fhidalgoh31/WChair/Board.png

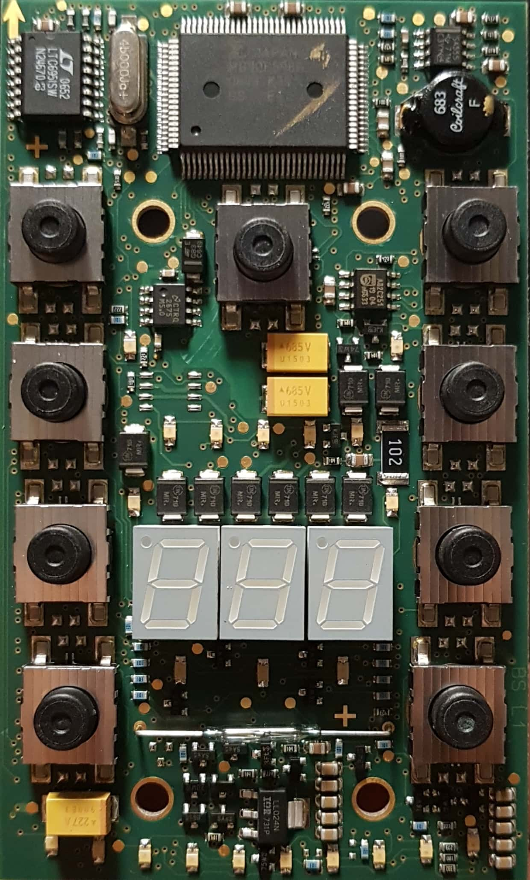
Board.png
