fhidalgoh31/WChair/chair_test/I2C-Master/README.md

The I2C Master library is an alternative library to Arduino's Wire library.
