fhidalgoh31/WChair/Motor controller selection.odt

# Motor controller – for driving the auxiliary motors forward - backwards

# Sabertooth 2X12 Dual Motor Driver – 24V 12 A

https://www.robotgear.com.au/Product.aspx/Details/461-Sabertooth-2X12-Dual-Motor-Driver

#### AUD $147.95

Qty needed: 2 → 4 motors

Connections: Screw terminals (not micro-fit)

Communication: 1 wire from Roboteq

Control: Needs configuration and some programming

Mounting: Mounting holes, no housing

Also needed (Qty=1):

https://www.altronics.com.au/p/z6369-rs232-serial-to-ttl-converter/

https://www.altronics.com.au/p/p1017-prototyping-jumper-wires-mixed-for-breadboard-arduino/

# Cytron Dual Channel 10A DC Motor Driver – 25 V 10A MAX

https://www.iot-store.com.au/products/cytron-dual-channel-10a-dc-motor-driver

AUD $25.00

Qty needed: 2 → 4 motors

Connections: Screw terminals (not micro-fit)

Communication: 8 Wires from Roboteq

Control: Straightforward use with Digital outputs from Roboteq

Mounting: Mounting holes, no housing

Also needed (Qty=1):

https://www.banggood.com/8-Channel-24V-To-5V-Optocoupler-Isolation-Module-PLC-Signal-Level-Voltage-Conversion-Board-p-1202825.html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

# Roboteq SDC2160 - Brushed DC Motor Controller, Dual Channel, 2 x 20A, 60V

https://www.roboteq.com/index.php/component/virtuemart/307/sdc2160-detail?Itemid=970

USD $250.00

Qty needed: 2 → 4 motors

Connections: Screw terminals (not micro-fit)

Communication: 2 Wires from Roboteq, CAN BUS

Control: CAN BUS from Roboteq, requires programming

Mounting: Mounting holes, housing

Note: Probably overkill

Voltage Regulator:

24V | V (v) | I (A) | qty | Sub
Nidec 404 682 x 4 | 24 | 3.5 | 1 | 3.5 | http://nidec-ma.de/en/productlist.html
Brake ??? | 24 | 2 | 1 | 2
Lights | 24 | | | 0
Roboteq | 24 | 0.1 | 1 | 0.1
Servo Nide 404.854 | 24 | 6 | 1 | 6
| | | | > 10 A | 240 W

# B70SR24125CC

24V, In: 36- 106V, 12.5A, 300W

https://www.digikey.com.au/product-detail/en/delta-electronics/B70SR24125CC/941-1809-ND/7681586 (https://www.digikey.com.au/product-detail/en/delta-electronics/B70SR24125CC/941-1809-ND/7681586)

Includes an Enable/Disable signal useful for saving power and lifespan

AU$209.02

Dim: 190.0mm x 75.9mm x 43.9mm

B62SR24015CC

24V, 360W, 15A

https://www.digikey.com.au/product-detail/en/delta-electronics/B62SR24015CC/1145-1283-ND/9598967

Includes an Enable/Disable signal useful for saving power and lifespan

AUD $272.00

Connection: Molex Mini Fit (Included)

Dim: 190.0mm x 76.0mm x 44.0mm

# SD-350C-24

https://www.digikey.com.au/product-detail/en/mean-well-usa-inc/SD-350C-24/1866-4431-ND/7706520

350W, 14.6 A

AU$135.60

Input: 36- 72V

Dim: 215.0mm x 115.0mm x 50.0mm

Molex: Micro Fit, Male:

AU$3.70

https://www.digikey.com.au/product-detail/en/molex-llc/0430450829/WM10700-ND/3310210

Joystick

We can go to:

http://www.controldevices.net/P&G/Joysticks.html

http://www.controldevices.net/contactus.html

Option:

https://www.digikey.com.au/product-detail/en/apem-inc/HF11S10/1040-1098-ND/4291721

https://www.digikey.com.au/product-detail/en/apem-inc/505-442/1040-1041-ND/4246202

Lists:

https://www.digikey.com.au/products/en/switches/navigation-switches-joystick/204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

https://au.rs-online.com/web/c/switches/joystick-switches-accessories/joystick-switches/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,4294840285,4294877055,4294885167,4294880316,4294885351,4294885229
