fhidalgoh31/WChair/pinout.xlsx

 |  |  | Top, capacitor, connector
 |  |  | in line to mini molex 8 pins -- male |  |  |  |  |  |  |  | joy
 |  |  |  | 8 | 6 |  |  |  | 1 | 4 | 1 | 8 | black | vcc
 |  | ext wired |  | gnd | 7 | 2 |  | 5 |  | 3 | 2 | 6 | white | left/right out 1
 |  |  |  |  |  |  |  |  |  |  | 3 | 7 | red | gnd
 |  |  |  |  |  |  |  |  |  |  | 4 | 2 | blue | forward/reverse out 1
 |  |  | Molex
Joystick | (numbers across)
1 | vcc |  | green
2 | left/right out 1
3 | gnd |  | notch
4 | forward/reverse out 1
5 | forward/reverse out 2
6 | Centre trap
7 | left/right out 2
 |  |  | Joystick 10 pin connector
 |  |  | MALE
 |  |  | vcc |  | vcc | gnd | gnd
 |  |  | gnd | CAN | CAN
 |  |  |  | notch
