fhidalgoh31/WChair/WIring/Wiring.pdf

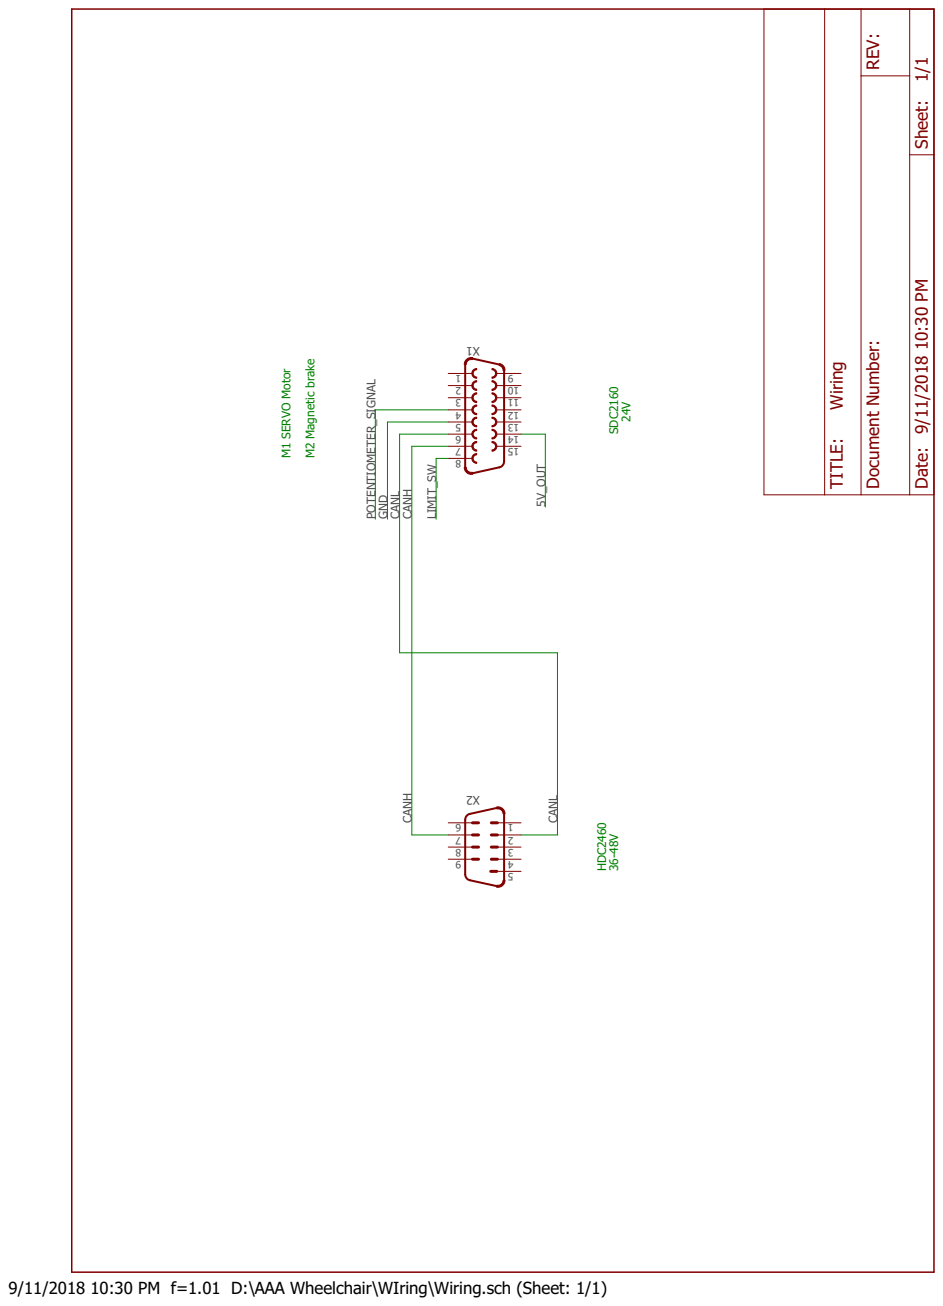
[picture p2: page 1]

M1 SERVO Motor M2 Magnetic brake

9/11/2018 10:30 PM f=1.01 D:\AAA Wheelchair\WIring\Wiring.sch (Sheet: 1/1)
