fhidalgoh31/WChair/Board/wchair.brd

## EAGLE design Board/wchair.brd (2019-07-08)

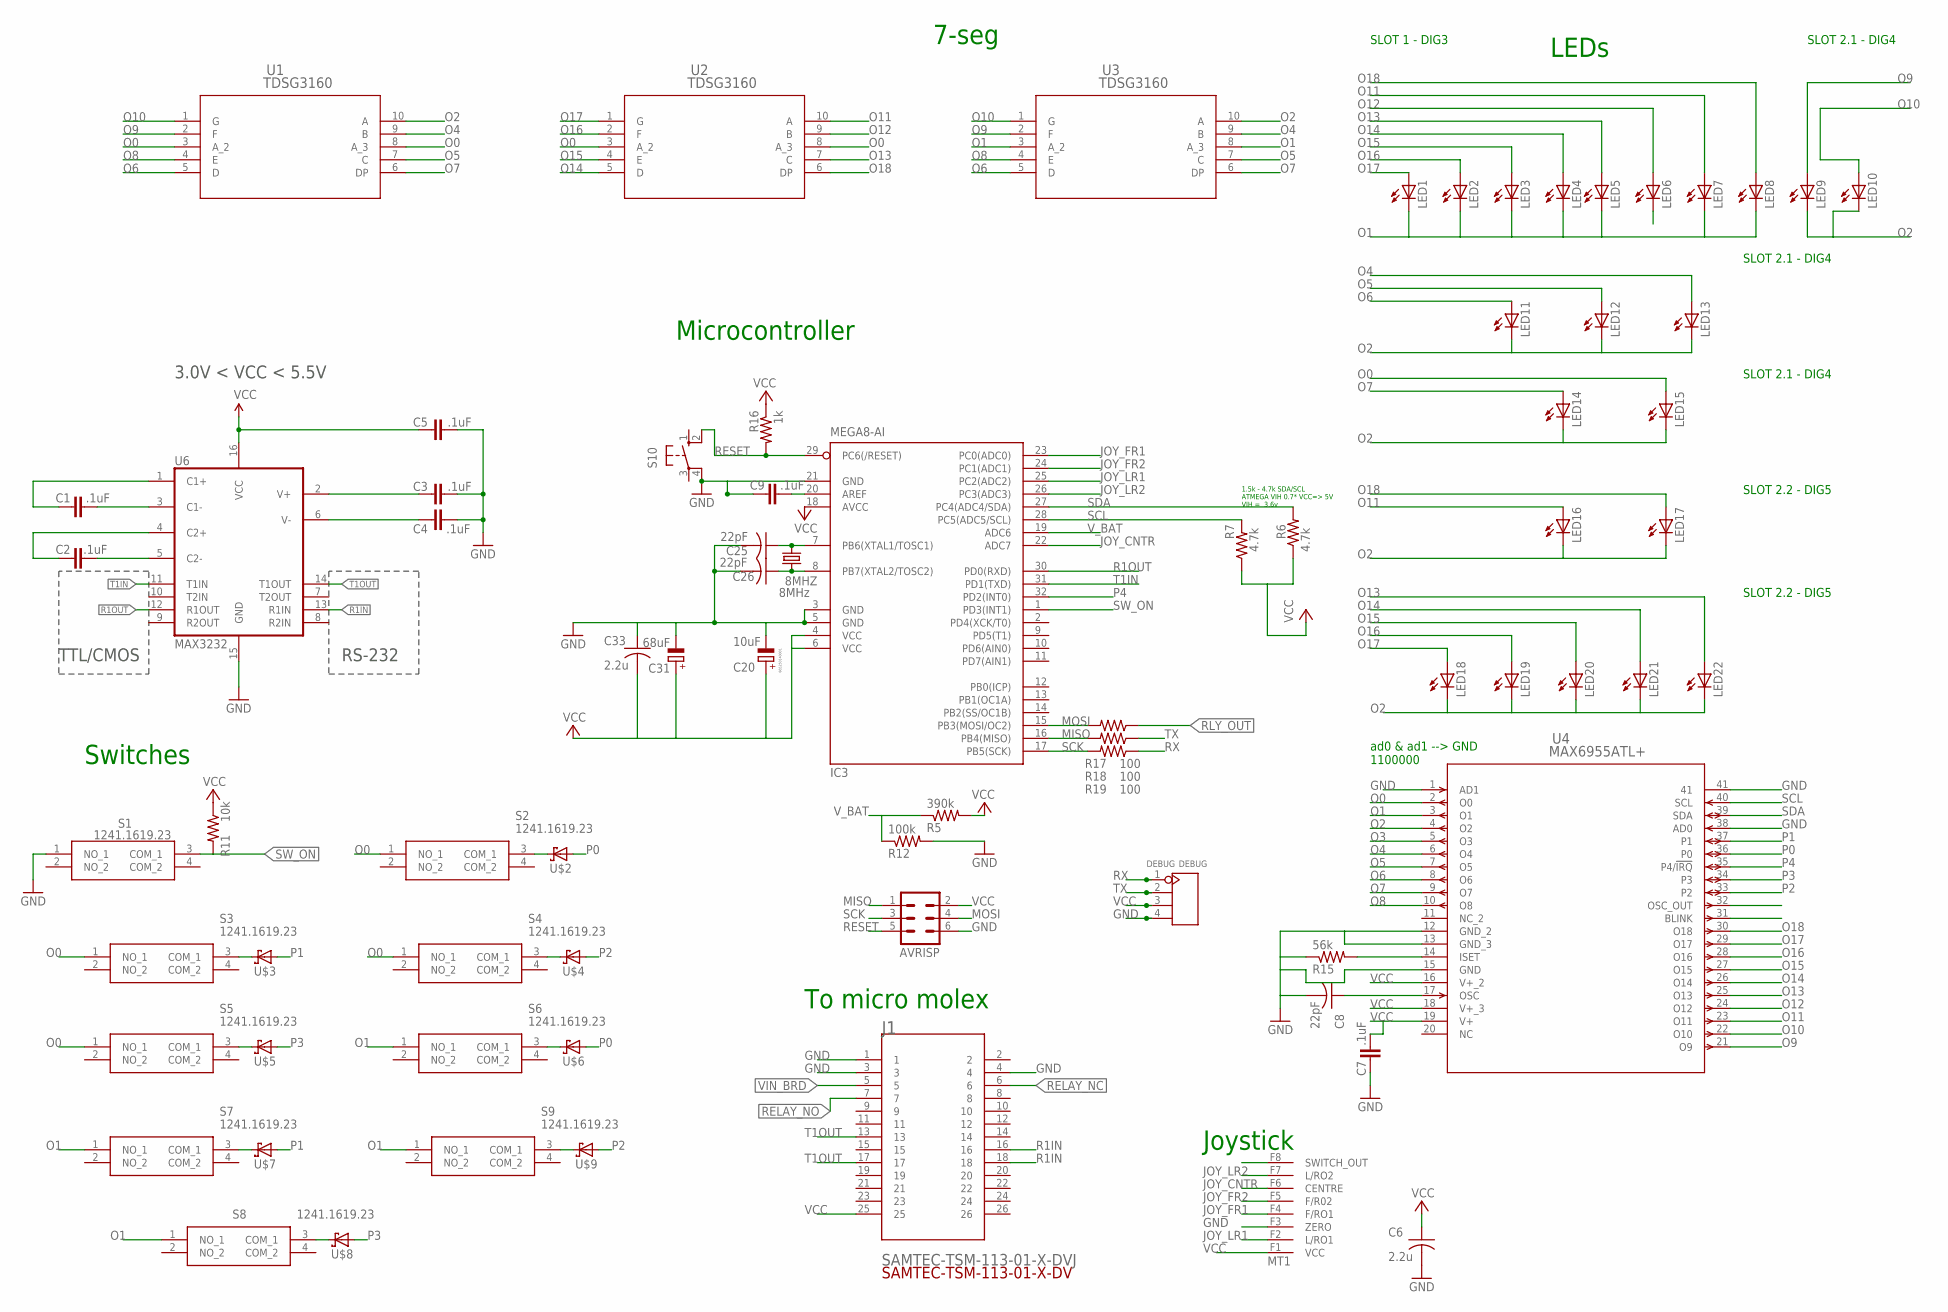
[picture p3: schematic wchair.sch, sheet 1]

Parts:
8MHZ: 8MHz; SM49; DIGIKEY 535-9089-1-ND
AVRISP: MA03-2; DIGIKEY ED10665-ND
C1, C2, C3, C4, C5, C7, C9: .1uF; 0603-CAP; DIGIKEY 399-15351-1-ND
C6, C33: 2.2u; C0603; DIGIKEY 1276-1183-1-ND
C8, C25, C26: 22pF; C0603; DIGIKEY 478-11384-1-ND
C20: 10uF; 153CLV-0405; DIGIKEY 493-2173-1-ND
C31: 68uF; 153CLV-0807; DIGIKEY PCE4412CT-ND‎
DEBUG: DEBUG; 4-PIN-HEADER; DIGIKEY 0
IC3: MEGA8-AI; TQFP32-08; DIGIKEY ATMEGA328P-AU-ND
J1: SAMTEC-TSM-113-01-X-DVJ; SAMTEC-TSM-113-01-X-DV
LED1, LED2, LED3, LED4, LED5, LED6, LED7, LED8, LED9, LED10, LED11, LED12, LED13, LED14, LED15, LED16, LED17, LED18, LED19, LED20, LED21, LED22: LEDCHIP-LED0805; CHIP-LED0805; DIGIKEY 1497-1434-1-ND
MT1: MINITEK2-8PINS
R5: 390k; R0603; DIGIKEY 311-390KGRCT-ND
R6, R7: 4.7k; R0603; DIGIKEY 311-4.7KGRCT-ND
R11: 10k; R0603; DIGIKEY RNCP0603FTD10K0CT-ND
R12: 100k; R0603; DIGIKEY RR08P100KDCT-ND
R15: 56k; R0603; DIGIKEY 749-1667-1-ND
R16: 1k; R0603; DIGIKEY RHM1.0KDCT-ND
R17, R18, R19: 100; R0603; DIGIKEY RR08P100DCT-ND
S1, S2, S3, S4, S5, S6, S7, S8, S9: 1241.1619.23; IP40-J-LEAD; DIGIKEY 486-1931-1-ND
S10: 10-XX; B3F-10XX; DIGIKEY SW400-ND
U1, U2, U3: TDSG3160; DIP10_TDS; DIGIKEY TDSG3160-M-ND
U4: MAX6955ATL+; 21-0141I_T4066-5
U6: MAX3232; SO16; DIGIKEY 296-14619-1-ND
U$2, U$3, U$4, U$5, U$6, U$7, U$8, U$9: SCHOTTKY; SOD-323

Connections:
C1+: C1.1, U6.1 (C1+)
C1-: C1.2, U6.3 (C1-)
C2+: C2.1, U6.4 (C2+)
C2-: C2.2, U6.5 (C2-)
GND: AVRISP.6, C3.2, C4.2, C5.2, C6.2, C7.1, C8.2, C9.1, C20.-, C25.2, C26.2, C31.-, C33.1, DEBUG.4, IC3.3 (GND), IC3.5 (GND), IC3.21 (GND), J1.1, J1.3, J1.4, MT1.F3 (ZERO), R12.2, R15.1, S1.1 (NO_1), S10.4 (P1), U4.1 (AD1), U4.12 (GND_2), U4.13 (GND_3), U4.15 (GND), U4.38 (AD0), U4.41, U6.15 (GND); also elsewhere on the board
JOY_CNTR: IC3.22 (ADC7), MT1.F6 (CENTRE)
JOY_FR1: IC3.23 (PC0(ADC0)), MT1.F4 (F/RO1)
JOY_FR2: IC3.24 (PC1(ADC1)), MT1.F5 (F/R02)
JOY_LR1: IC3.25 (PC2(ADC2)), MT1.F2 (L/RO1)
JOY_LR2: IC3.26 (PC3(ADC3)), MT1.F7 (L/RO2)
MISO: AVRISP.1, IC3.16 (PB4(MISO)), R18.2
MOSI: AVRISP.4, IC3.15 (PB3(MOSI/OC2)), R19.2
unnamed: S2.3 (COM_1), U$2.C
unnamed: S9.3 (COM_1), U$9.C
unnamed: S7.3 (COM_1), U$7.C
unnamed: S8.3 (COM_1), U$8.C
unnamed: S6.3 (COM_1), U$6.C
unnamed: S4.3 (COM_1), U$4.C
unnamed: S5.3 (COM_1), U$5.C
unnamed: S3.3 (COM_1), U$3.C
unnamed: R15.2, U4.14 (ISET)
unnamed: C8.1, U4.17 (OSC)
unnamed: 8MHZ.2, C25.1, IC3.7 (PB6(XTAL1/TOSC1))
unnamed: 8MHZ.1, C26.1, IC3.8 (PB7(XTAL2/TOSC2))
unnamed: C9.2, IC3.20 (AREF)
O0: LED15.A, S2.1 (NO_1), S3.1 (NO_1), S4.1 (NO_1), S5.1 (NO_1), U1.3 (A_2), U1.8 (A_3), U2.3 (A_2), U2.8 (A_3), U4.2 (O0)
O1: LED1.C, LED2.C, LED3.C, LED4.C, LED5.C, LED7.C, LED8.C, S6.1 (NO_1), S7.1 (NO_1), S8.1 (NO_1), S9.1 (NO_1), U3.3 (A_2), U3.8 (A_3), U4.3 (O1)
O2: LED9.C, LED10.C, LED11.C, LED12.C, LED13.C, LED14.C, LED15.C, LED16.C, LED17.C, LED18.C, LED19.C, LED20.C, LED21.C, LED22.C, U1.10 (A), U3.10 (A), U4.4 (O2)
O3: U4.5 (O3)
O4: LED13.A, U1.9 (B), U3.9 (B), U4.6 (O4)
O5: LED12.A, U1.7 (C), U3.7 (C), U4.7 (O5)
O6: LED11.A, U1.5 (D), U3.5 (D), U4.8 (O6)
O7: LED14.A, U1.6 (DP), U3.6 (DP), U4.9 (O7)
O8: U1.4 (E), U3.4 (E), U4.10 (O8)
O9: LED9.A, U1.2 (F), U3.2 (F), U4.21 (O9)
O10: LED10.A, U1.1 (G), U3.1 (G), U4.22 (O10)
O11: LED7.A, LED16.A, U2.10 (A), U4.23 (O11)
O12: LED6.A, U2.9 (B), U4.24 (O12)
O13: LED5.A, LED22.A, U2.7 (C), U4.25 (O13)
O14: LED4.A, LED21.A, U2.5 (D), U4.26 (O14)
O15: LED3.A, LED20.A, U2.4 (E), U4.27 (O15)
O16: LED2.A, LED19.A, U2.2 (F), U4.28 (O16)
O17: LED1.A, LED18.A, U2.1 (G), U4.29 (O17)
O18: LED8.A, LED17.A, U2.6 (DP), U4.30 (O18)
P0: U4.36 (P0), U$2.A, U$6.A
P1: U4.37 (P1), U$3.A, U$7.A
P2: U4.33 (P2), U$4.A, U$9.A
P3: U4.34 (P3), U$5.A, U$8.A
P4: IC3.32 (PD2(INT0)), U4.35 (P4/!IRQ)
R1IN: J1.16, J1.18, U6.13 (R1IN)
R1OUT: IC3.30 (PD0(RXD)), U6.12 (R1OUT)
RELAY_NC: J1.6; also elsewhere on the board
RELAY_NO: J1.7; also elsewhere on the board
RESET: AVRISP.5, IC3.29 (PC6(/RESET)), R16.2, S10.2 (S1)
RLY_OUT: R19.1; also elsewhere on the board
RX: DEBUG.1, R17.1
SCK: AVRISP.3, IC3.17 (PB5(SCK)), R17.2
SCL: IC3.28 (PC5(ADC5/SCL)), R7.2, U4.40 (SCL)
SDA: IC3.27 (PC4(ADC4/SDA)), R6.2, U4.39 (SDA)
SW_ON: IC3.1 (PD3(INT1)), R11.2, S1.3 (COM_1)
T1IN: IC3.31 (PD1(TXD)), U6.11 (T1IN)
T1OUT: J1.13, J1.17, U6.14 (T1OUT)
TX: DEBUG.2, R18.1
V+: C3.1, U6.2 (V+)
V-: C4.1, U6.6 (V-)
VCC: AVRISP.2, C5.1, C6.1, C7.2, C20.+, C31.+, C33.2, DEBUG.3, IC3.4 (VCC), IC3.6 (VCC), IC3.18 (AVCC), J1.25, MT1.F1 (VCC), R5.2, R6.1, R7.1, R11.1, R16.1, U4.16 (V+_2), U4.18 (V+_3), U4.19 (V+), U6.16 (VCC); also elsewhere on the board
VIN_BRD: J1.5; also elsewhere on the board
V_BAT: IC3.19 (ADC6), R5.1, R12.1

Notes on the sheet:
1.5k - 4.7k SDA/SCL ATMEGA VIH 0.7* VCC=> 5V VIH = 3.6v
Microcontroller
To micro molex
Joystick
Switches
7-seg
LEDs
RS-232
TTL/CMOS
3.0V < VCC < 5.5V
ad0 & ad1 --> GND 1100000
SLOT 1 - DIG3
SLOT 2.1 - DIG4
SLOT 2.2 - DIG5

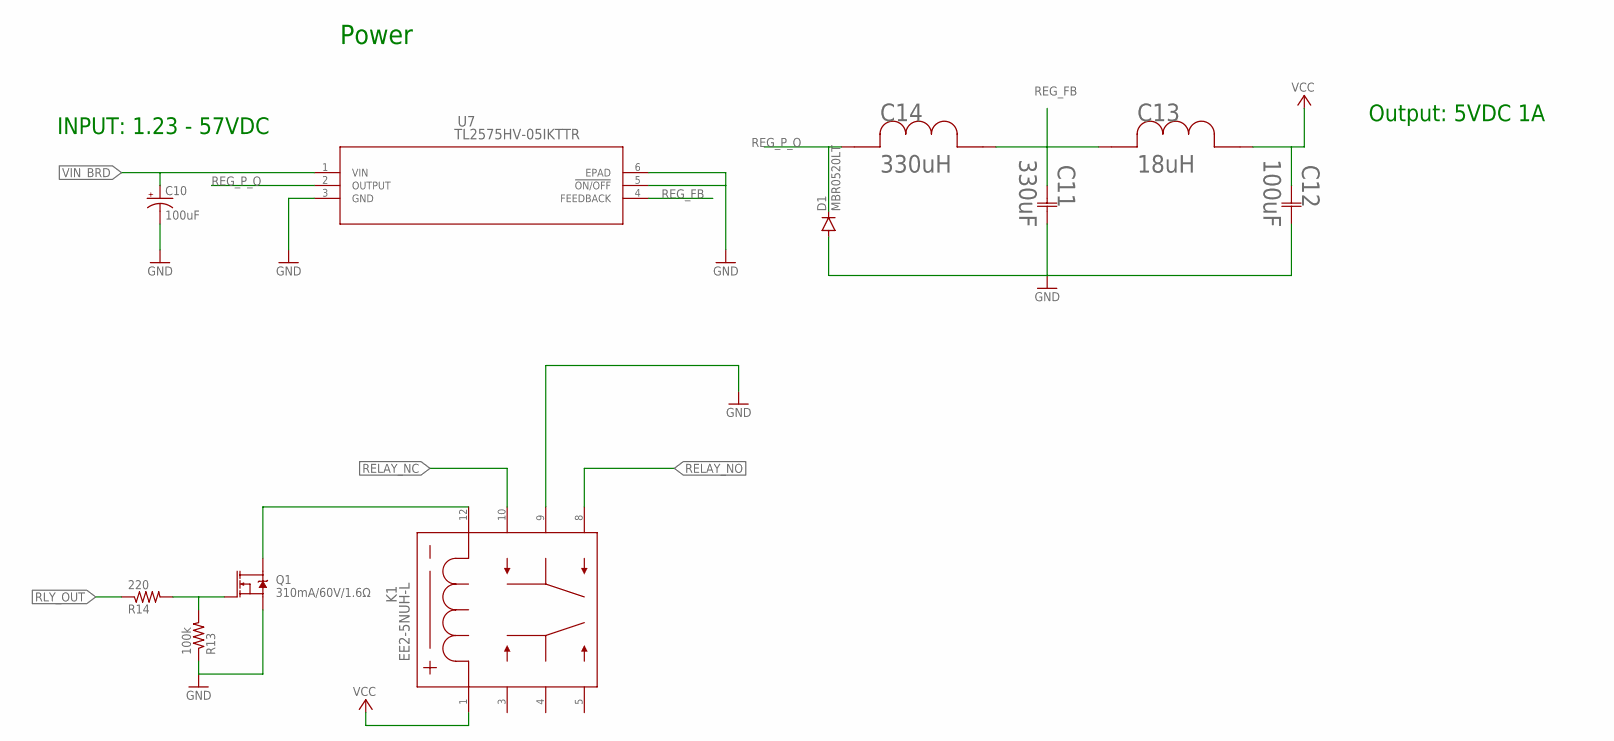
[picture p4: schematic wchair.sch, sheet 2]

Parts:
C10: 100uF; NIC_10X10.5_CAP; DIGIKEY PCE3942CT-ND
C11: 330uF; CAP_EEFK_D8; DIGIKEY PCE3768CT-ND
C12: 100uF; CAP_EEE_D; DIGIKEY PCE3852CT-ND
C13: 18uH; 18UH2.15A; DIGIKEY 732-4533-1-ND
C14: 330uH; 732-1698-1-ND; DIGIKEY 732-1698-1-ND
D1: MBR0520LT; SOD123; DIGIKEY MBR0520LCT-ND
K1: EE2-5NUH-L; EE2NUH; DIGIKEY 399-11016-1-ND‎
Q1: 310mA/60V/1.6Ω; SOT323; DIGIKEY SI2304BDS-T1-GE3CT-ND
R13: 100k; R0603; DIGIKEY RR08P100KDCT-ND
R14: 220; R0603; DIGIKEY A130087CT-ND
U7: TL2575HV-05IKTTR; KTT5_6P22X6P86; DIGIKEY 296-21833-1-ND

Connections:
GND: C10.-, C11.2, C12.2, D1.A, K1.9 (6), Q1.2 (S), R13.1, U7.3 (GND), U7.5 (!ON/OFF), U7.6 (EPAD); also elsewhere on the board
unnamed: Q1.1 (G), R13.2, R14.2
unnamed: K1.12 (8), Q1.3 (D)
REG_FB: C11.1, C13.1, C14.2, U7.4 (FEEDBACK)
REG_P_O: C14.1, D1.C, U7.2 (OUTPUT)
RELAY_NC: K1.10 (7); also elsewhere on the board
RELAY_NO: K1.8 (5); also elsewhere on the board
RLY_OUT: R14.1; also elsewhere on the board
VCC: C12.1, C13.2, K1.1; also elsewhere on the board
VIN_BRD: C10.+, U7.1 (VIN); also elsewhere on the board

Notes on the sheet:
Power
Output: 5VDC 1A
INPUT: 1.23 - 57VDC

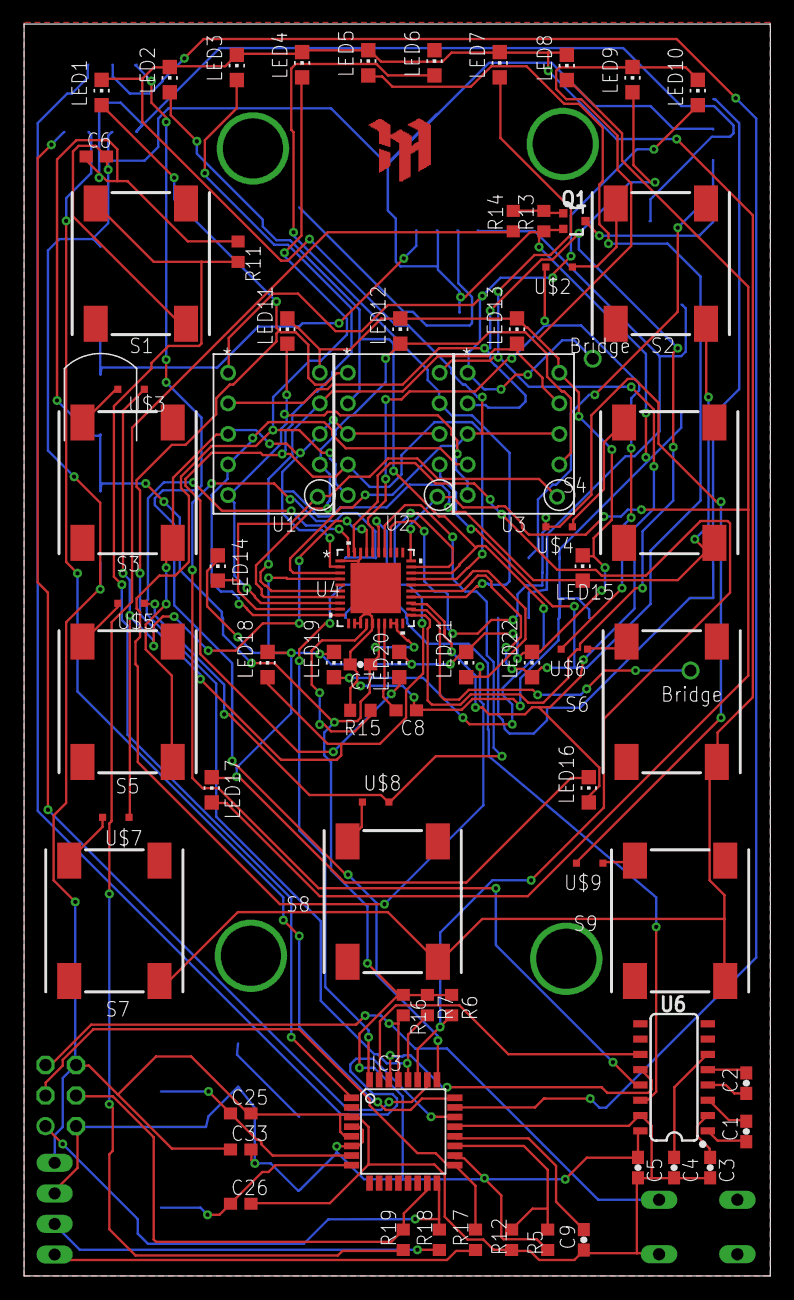
[picture p5: board wchair.brd from above]

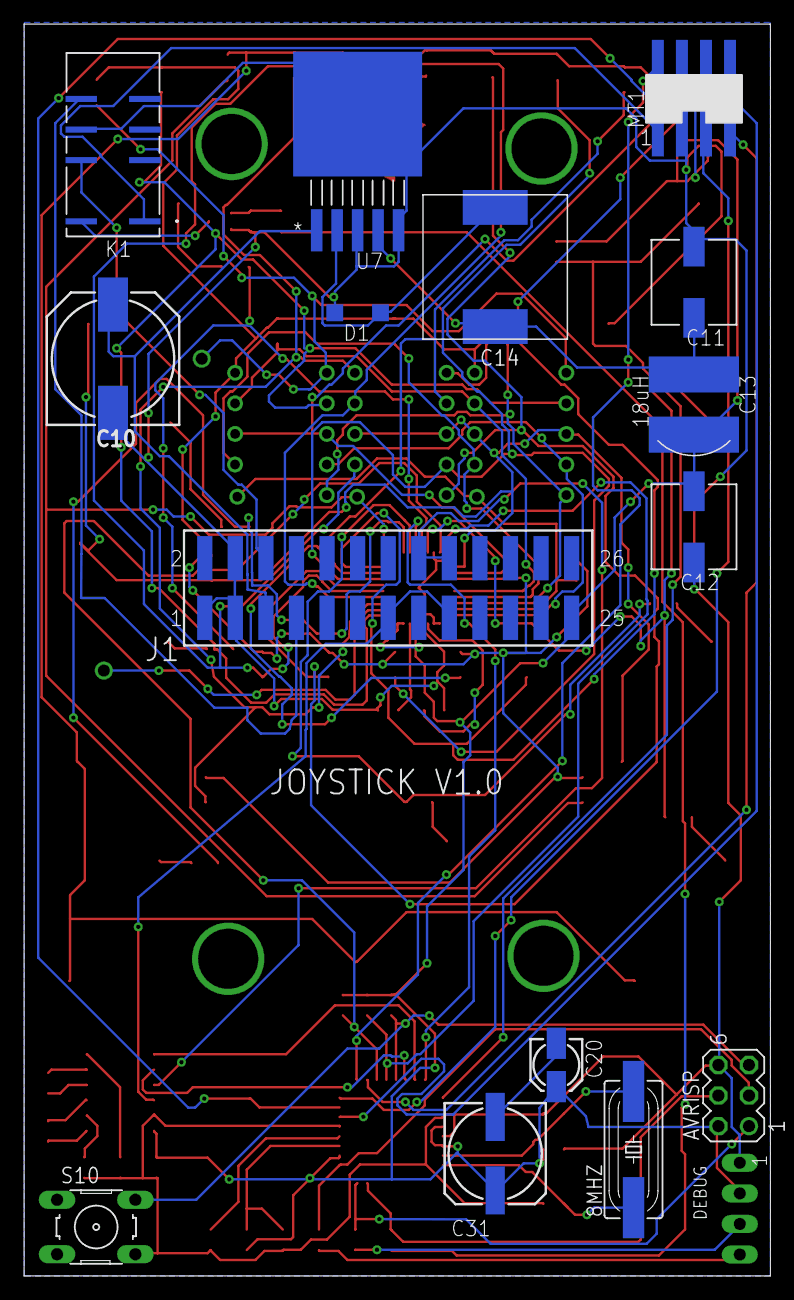
[picture p6: board wchair.brd from below]

Board: 2 copper layers, 62.0 x 104.0 mm, 86 parts (16 on the bottom side), 71 nets.
