fhidalgoh31/WChair/chair_code/MAX6955_i2c.cpp

/*
 * MAX6955
 * Copyright 2013 Philipp Klaus
 */

#include "MAX6955_i2c.h"
#include "I2C.h"
#include <SoftwareSerial.h>

MAX6955::MAX6955(char id)
{
    _id = (id & 0x0F) | 0x60;
    // // this is the same as
    // // _id = _id & B1111 | B1100000;
    _id=id;
}
char MAX6955::init()
{
    I2c.timeOut(80);
    I2c.begin();
    // ↓ 0x00 = No decode for any digit
    //   0xFF = hexadecimal decode for all digits
    write(max6955_reg_decodeMode,0xFF);  //no decode
    // ↓ 0x00 =  1/16 (min on)  2.5 mA typical segment current
    //   0x0F = 15/16 (max on) 37.5 mA
    write(max6955_reg_globalIntensity,0x07);
    // ↓ 0x00 display only digit 0
    //   0x07 display all digits 0-7
    write(max6955_reg_scanLimit,0x05);
    // ↓ 0x00: Shutdown
    //   0x01: Normal operation
    //   0x20: Blink timing counters reset at I2C ack
    //   0x00: Global intensity
    //   0x40: Individual intensity settings
    //write(max6955_reg_configuration, 0x21);
    write(max6955_reg_configuration,0x01);
    // D7-D5: # keys scan   D4-D0 Port direction 1:input
    write(max6955_reg_portConfiguration,0B01011000);   // scan o0,o1, input p0,p1
    // ↓ 0xFF = digits 0-7 are 14-segment digits
    //   0x00 = digits 0-7 are 16- or 7-segment digits
    write(max6955_reg_digitType,0x00);
    // ↓ 0x00 = Display Test Off
    // write(max6955_reg_displayTest,0x00);
    return _id;
}
//return number of attempts
int MAX6955::write(char command, char data){
    int i;
    while (1)
    {
        int j=I2c.write(_id,command,data);
        // mySerial.print("write return: "); mySerial.println(j);
        i++;
        if (j==0)
            break;
    }
    return i;
}
 
void MAX6955::clear(){
    for(int i = max6955_reg_digit0; i <= max6955_reg_digit5; i++)
        write(i, 0x00);
}

byte MAX6955::read(char command)
{
    I2c.read(_id,command,1); //read 6 bytes (x,y,z) from the device
    return I2c.receive();
}
